je1rav/KD8CEC_C-BOARD_for_UV-K5/(commit log)

2025-12-03 Revise README with C-BOARD firmware details
    Updated README.md to include detailed information about the C-BOARD (DSP-Board) for UV-K5 firmware, features, and instructions for FT8 communication.
2025-12-03 Add KiCad and Gerber file links for UV-K5 PCBs
    Updated PCB KiCad and Gerber file links for UV-K5.
2025-12-03 Update README with frequency measurement adjustments
    Clarified frequency measurement and PWM output details.
2025-12-03 Revise README for Arduino-pico USB audio details
    Updated the README to clarify limitations and usage instructions for Arduino-pico with USB audio support.
2025-12-04 Update README to remove file references
    Removed references to Kicad and Gerber files in the README.
2025-12-05 Revise README with updated diagrams and file references
    Updated circuit diagram and file paths for PCB designs. Improved clarity in descriptions regarding firmware and hardware modifications.
2025-12-05 Fix typo in README about改造ボード
2025-12-08 Update README with blog link and Arduino-pico details
    Updated blog link for further details and added information about the Arduino-pico board manager version.
2025-12-09 Fix grammatical error in README about board compatibility
    Corrected a grammatical error in the README regarding compatibility with the original C-BOARD.
2025-12-09 Fix DIG mode instruction for UV-K5
    Corrected the instruction regarding switching the DIG mode on the UV-K5.
