je1rav/KD8CEC_C-BOARD_for_UV-K5/(notices)

Notices in the files:
UV-K5_Cable_RP2040_IJV_mbed/UV-K5_Cable_RP2040_IJV_mbed.ino:
UV-K5_Cable_RP2040_IJV_mbed.ino is free software: you can redistribute it and/or modify
it under the terms of the GNU General Public License as published by
the Free Software Foundation, either version 3 of the License, or
any later version.
